HalFrgrd/wirelesskeyboard/README.md

---
layout: default
title: Wireless keyboard project
has_children: true
---

## Wireless keyboard

Resources for making a wireless keyboard.
Also general electronics resources.

- [Unnamed 40% keyboard](60_case_keyboard/README.md)
