HalFrgrd/wirelesskeyboard/60_case_keyboard/60_case_keyboard.kicad_pcb

## KiCad design 60_case_keyboard/60_case_keyboard.kicad_pcb (2021-04-16)

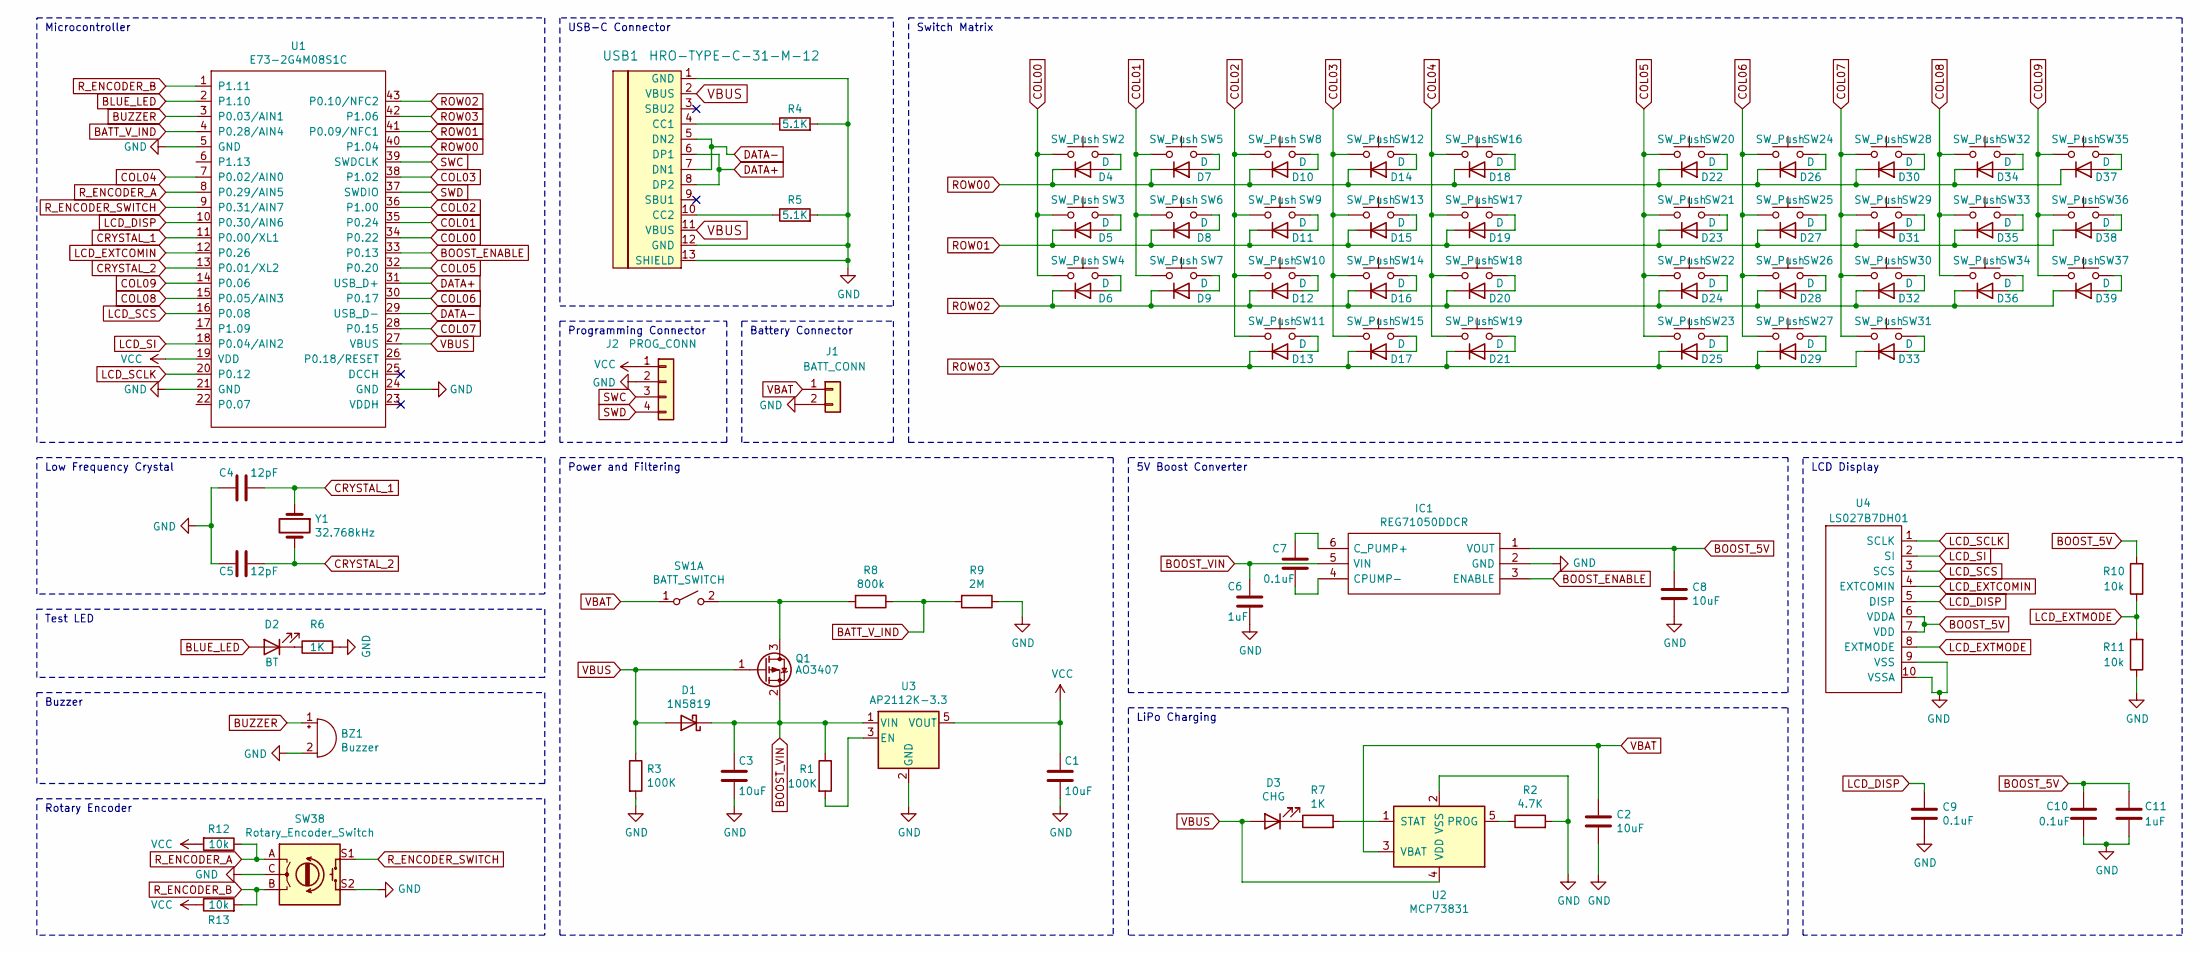
[picture p1: schematic 60_case_keyboard.sch]

Parts:
BZ1: Buzzer; Buzzer_12x9.5RM7.6
C1, C2, C3, C8: 10uF; C_1206_3216Metric_Pad1.42x1.75mm_HandSolder
C4, C5: 12pF; C_1206_3216Metric_Pad1.42x1.75mm_HandSolder
C6, C11: 1uF; C_1206_3216Metric_Pad1.42x1.75mm_HandSolder
C7, C9, C10: 0.1uF; C_1206_3216Metric_Pad1.42x1.75mm_HandSolder
D1: 1N5819; D_SOD-123
D2: BT; LED_0603_1608Metric
D3: CHG; LED_0603_1608Metric
D4, D5, D6, D7, D8, D9, D10, D11, D12, D13, D14, D15, D16, D17, D18, D19, D20, D21, D22, D23, D24, D25, D26, D27, D28, D29, D30, D31, D32, D33, D34, D35, D36, D37, D38, D39: D; D_DO-35_SOD27_P7.62mm_Horizontal
IC1: REG71050DDCR; SOT95P280X110-6N; Mouser Part Number 595-REG71050DDCR
J1: BATT_CONN; JST_EH_S2B-EH_1x02_P2.50mm_Horizontal
J2: PROG_CONN; PinHeader_1x04_P2.54mm_Vertical
Q1: AO3407; SOT-23
R1, R3: 100K; R_Axial_DIN0204_L3.6mm_D1.6mm_P5.08mm_Horizontal
R2: 4.7K; R_Axial_DIN0204_L3.6mm_D1.6mm_P5.08mm_Horizontal
R4, R5: 5.1K; R_Axial_DIN0204_L3.6mm_D1.6mm_P5.08mm_Horizontal
R6, R7: 1K; R_Axial_DIN0204_L3.6mm_D1.6mm_P5.08mm_Horizontal
R8: 800k; R_Axial_DIN0204_L3.6mm_D1.6mm_P5.08mm_Horizontal
R9: 2M; R_Axial_DIN0204_L3.6mm_D1.6mm_P5.08mm_Horizontal
R10, R11, R12, R13: 10k; R_Axial_DIN0204_L3.6mm_D1.6mm_P5.08mm_Horizontal
SW1: BATT_SWITCH; MSK-12D19_Sliding_Switch
SW2, SW3, SW4, SW5, SW6, SW7, SW8, SW9, SW10, SW11, SW12, SW13, SW14, SW15, SW16, SW17, SW18, SW19, SW20, SW21, SW22, SW23, SW24, SW25, SW26, SW27, SW28, SW29, SW30, SW31, SW32, SW33, SW34, SW35, SW36, SW37: SW_Push; SW_PG1350_reversible
SW38: Rotary_Encoder_Switch; RotaryEncoder_Alps_EC11E-Switch_Vertical_H20mm
U1: E73-2G4M08S1C; E73-2G4M08S1C-52840_with_breakout
U2: MCP73831; SOT-23-5
U3: AP2112K-3.3; SOT-23-5
U4: LS027B7DH01; 0527451033_flipped
USB1: HRO-TYPE-C-31-M-12
Y1: 32.768kHz; Crystal_DS26_D2.0mm_L6.0mm_Horizontal

Connections:
BATT_V_IND: R8.1, R9.2, U1.4 (P0.28/AIN4)
BLUE_LED: D2.2 (A), U1.2 (P1.10)
BOOST_5V: C8.1, C10.1, C11.1, IC1.1 (VOUT), R10.2, U4.6 (VDDA), U4.7 (VDD)
BOOST_ENABLE: IC1.3 (ENABLE), U1.33 (P0.13)
BOOST_VIN: C3.1, C6.1, D1.1 (K), IC1.5 (VIN), Q1.2 (S), R1.1, U3.1 (VIN)
BUZZER: BZ1.1 (-), U1.3 (P0.03/AIN1)
COL00: SW2.1, SW3.1, SW4.1, U1.34 (P0.22)
COL01: SW5.1, SW6.1, SW7.1, U1.35 (P0.24)
COL02: SW8.1, SW9.1, SW10.1, SW11.1, U1.36 (P1.00)
COL03: SW12.1, SW13.1, SW14.1, SW15.1, U1.38 (P1.02)
COL04: SW16.1, SW17.1, SW18.1, SW19.1, U1.7 (P0.02/AIN0)
COL05: SW20.1, SW21.1, SW22.1, SW23.1, U1.32 (P0.20)
COL06: SW24.1, SW25.1, SW26.1, SW27.1, U1.30 (P0.17)
COL07: SW28.1, SW29.1, SW30.1, SW31.1, U1.28 (P0.15)
COL08: SW32.1, SW33.1, SW34.1, U1.15 (P0.05/AIN3)
COL09: SW35.1, SW36.1, SW37.1, U1.14 (P0.06)
CRYSTAL_1: C4.1, U1.11 (P0.00/XL1), Y1.1
CRYSTAL_2: C5.1, U1.13 (P0.01/XL2), Y1.2
DATA+: U1.31 (USB_D+), USB1.6 (DP1), USB1.8 (DP2)
DATA-: U1.29 (USB_D-), USB1.5 (DN2), USB1.7 (DN1)
GND: BZ1.2 (+), C1.2, C2.2, C3.2, C4.2, C5.2, C6.2, C8.2, C9.2, C10.2, C11.2, IC1.2 (GND), J1.2, J2.2, R2.2, R3.2, R4.2, R5.2, R6.2, R9.1, R11.1, SW38.C, SW38.S2, U1.5 (GND), U1.21 (GND), U1.24 (GND), U2.2 (VSS), U3.2 (GND), U4.9 (VSS), U4.10 (VSSA), USB1.1 (GND), USB1.12 (GND), USB1.13 (SHIELD)
LCD_DISP: C9.1, U1.10 (P0.30/AIN6), U4.5 (DISP)
LCD_EXTCOMIN: U1.12 (P0.26), U4.4 (EXTCOMIN)
LCD_EXTMODE: R10.1, R11.2, U4.8 (EXTMODE)
LCD_SCLK: U1.20 (P0.12), U4.1 (SCLK)
LCD_SCS: U1.16 (P0.08), U4.3 (SCS)
LCD_SI: U1.18 (P0.04/AIN2), U4.2 (SI)
unnamed: C7.1, IC1.6 (C_PUMP+)
unnamed: C7.2, IC1.4 (CPUMP-)
unnamed: D2.1 (K), R6.1
unnamed: D3.1 (K), R7.1
unnamed: D4.2 (A), SW2.2
unnamed: D5.2 (A), SW3.2
unnamed: D6.2 (A), SW4.2
unnamed: D7.2 (A), SW5.2
unnamed: D8.2 (A), SW6.2
unnamed: D9.2 (A), SW7.2
unnamed: D10.2 (A), SW8.2
unnamed: D11.2 (A), SW9.2
unnamed: D12.2 (A), SW10.2
unnamed: D13.2 (A), SW11.2
unnamed: D14.2 (A), SW12.2
unnamed: D15.2 (A), SW13.2
unnamed: D16.2 (A), SW14.2
unnamed: D17.2 (A), SW15.2
unnamed: D18.2 (A), SW16.2
unnamed: D19.2 (A), SW17.2
unnamed: D20.2 (A), SW18.2
unnamed: D21.2 (A), SW19.2
unnamed: D22.2 (A), SW20.2
unnamed: D23.2 (A), SW21.2
unnamed: D24.2 (A), SW22.2
unnamed: D25.2 (A), SW23.2
unnamed: D26.2 (A), SW24.2
unnamed: D27.2 (A), SW25.2
unnamed: D28.2 (A), SW26.2
unnamed: D29.2 (A), SW27.2
unnamed: D30.2 (A), SW28.2
unnamed: D31.2 (A), SW29.2
unnamed: D32.2 (A), SW30.2
unnamed: D33.2 (A), SW31.2
unnamed: D34.2 (A), SW32.2
unnamed: D35.2 (A), SW33.2
unnamed: D36.2 (A), SW34.2
unnamed: D37.2 (A), SW35.2
unnamed: D38.2 (A), SW36.2
unnamed: D39.2 (A), SW37.2
unnamed: Q1.3 (D), R8.2, SW1.2 (B)
unnamed: R1.2, U3.3 (EN)
unnamed: R2.1, U2.5 (PROG)
unnamed: R4.1, USB1.4 (CC1)
unnamed: R5.1, USB1.10 (CC2)
unnamed: R7.2, U2.1 (STAT)
ROW00: D4.1 (K), D7.1 (K), D10.1 (K), D14.1 (K), D18.1 (K), D22.1 (K), D26.1 (K), D30.1 (K), D34.1 (K), D37.1 (K), U1.40 (P1.04)
ROW01: D5.1 (K), D8.1 (K), D11.1 (K), D15.1 (K), D19.1 (K), D23.1 (K), D27.1 (K), D31.1 (K), D35.1 (K), D38.1 (K), U1.41 (P0.09/NFC1)
ROW02: D6.1 (K), D9.1 (K), D12.1 (K), D16.1 (K), D20.1 (K), D24.1 (K), D28.1 (K), D32.1 (K), D36.1 (K), D39.1 (K), U1.43 (P0.10/NFC2)
ROW03: D13.1 (K), D17.1 (K), D21.1 (K), D25.1 (K), D29.1 (K), D33.1 (K), U1.42 (P1.06)
R_ENCODER_A: R12.1, SW38.A, U1.8 (P0.29/AIN5)
R_ENCODER_B: R13.2, SW38.B, U1.1 (P1.11)
R_ENCODER_SWITCH: SW38.S1, U1.9 (P0.31/AIN7)
SWC: J2.3, U1.39 (SWDCLK)
SWD: J2.4, U1.37 (SWDIO)
VBAT: C2.1, J1.1, SW1.1 (A), U2.3 (VBAT)
VBUS: D1.2 (A), D3.2 (A), Q1.1 (G), R3.1, U1.27 (VBUS), U2.4 (VDD), USB1.2 (VBUS), USB1.11 (VBUS)
VCC: C1.1, J2.1, R12.2, R13.1, U1.19 (VDD), U3.5 (VOUT)

Notes on the sheet:
LiPo Charging
Rotary Encoder
Buzzer
Test LED
Low Frequency Crystal
Microcontroller
USB-C Connector
Programming Connector
Battery Connector
Switch Matrix
Power and Filtering
5V Boost Converter
LCD Display

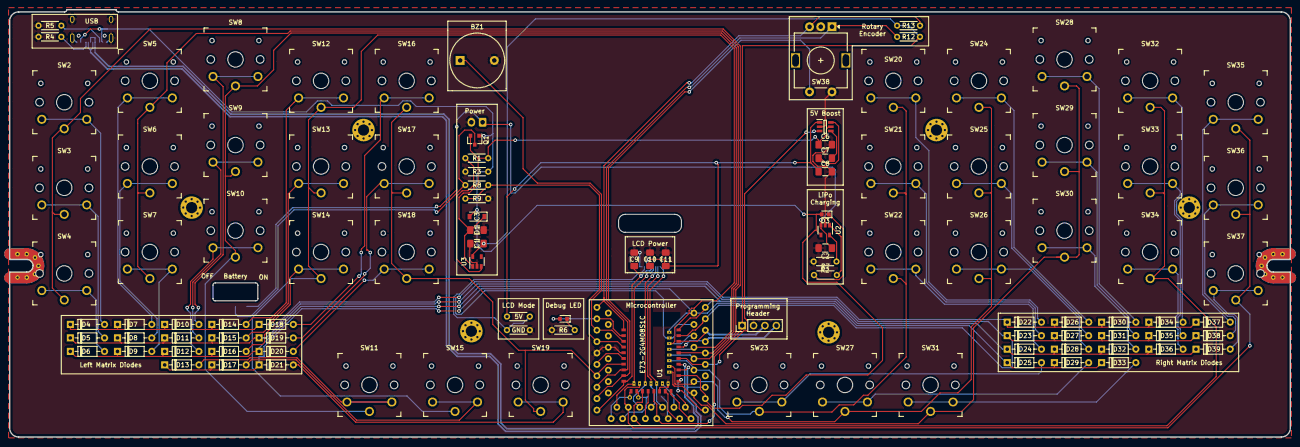
[picture p2: board 60_case_keyboard.kicad_pcb from above]

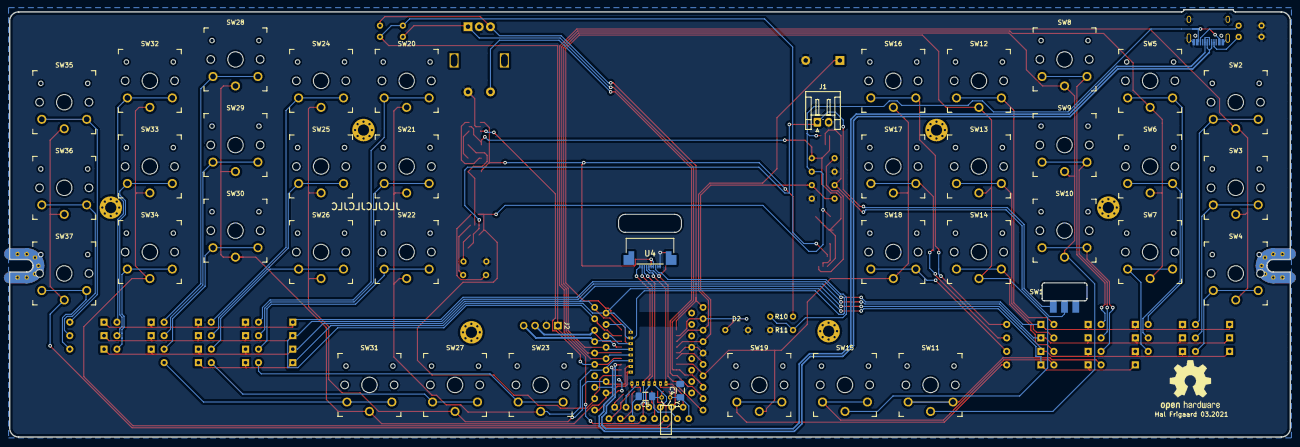
[picture p3: board 60_case_keyboard.kicad_pcb from below]

Board: 2 copper layers, 285.0 x 95.1 mm, 112 parts (7 on the bottom side), 85 nets.
