HalFrgrd/wirelesskeyboard/(commit log)

2021-03-27 Added 60% keyboard design
    [60_case_keyboard.kicad_pcb, 60_case_keyboard.sch]
2021-04-16 Info on flashing
    [60_case_keyboard.kicad_pcb]
